joeferner/stm32f1DevBoard/README.md

# STM32F1xxx Dev Board

STM32F1xxx ARM Dev board with Microchip MRF24WB0MA WiFi and SD Card.

## Resources

* [Programming STM32 F2, F4 ARMs under Linux: A Tutorial from Scratch](http://www.triplespark.net/elec/pdev/arm/stm32.html)
* [stm32flash](http://code.google.com/p/stm32flash/)
