joeferner/stm32f1DevBoard/hardware/stm32f1DevBoard.kicad_pcb

## KiCad design hardware/stm32f1DevBoard.kicad_pcb (2013-02-13)

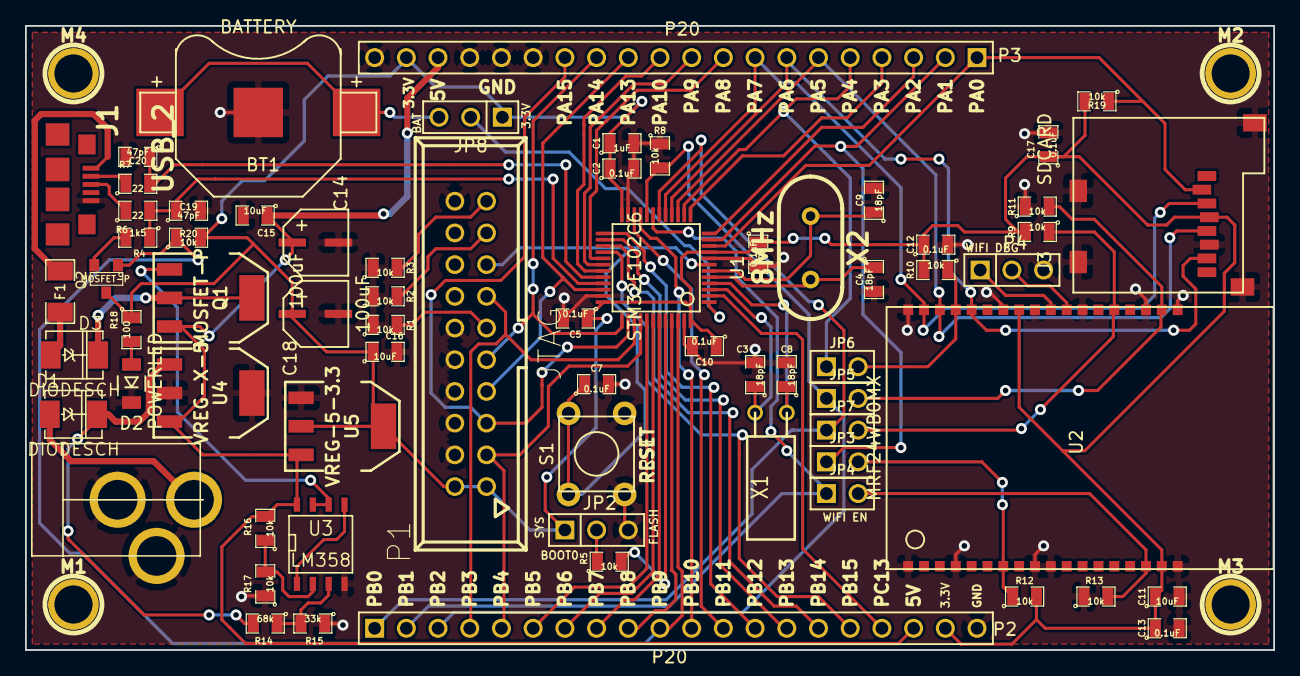
[picture p1: board stm32f1DevBoard.kicad_pcb from above]

Board: 2 copper layers, 100.0 x 50.0 mm, 73 parts (0 on the bottom side), 68 nets.

Parts:
BT1: BATTERY; BATTERY-COIN
C1: 1uF; SM0805
C2, C5, C6, C7, C10, C12, C13, C17: 0.1uF; SM0805
C3, C4, C8, C9: 18pF; SM0805
C11, C15, C16: 10uF; SM0805
C14, C18: 100uF; CAP-CAN-5mm
C19, C20: 47pF; SM0805
D1, D3: DIODESCH; DO-214AC(SMA)
D2: POWERLED; LED-1206
F1: FUSE; SM1206
J1: USB_2; USBMICRO
J2: POWER_JACK; POWER-IN-JACK-PMS
J3: SDCARD
JP2: BOOT0; PIN_ARRAY_3X1
JP3: WIFIRESET; PIN_ARRAY_2X1
JP4: WIFIWP; PIN_ARRAY_2X1
JP5: WIFIHIBERNATE; PIN_ARRAY_2X1
JP6: WIFIINT; PIN_ARRAY_2X1
JP7: WIFICS; PIN_ARRAY_2X1
JP8: BATTERYENABLE; PIN_ARRAY_3X1
M1, M2, M3, M4: Mounting Hole; 1pin
P1: JTAG; VASCH10x2
P2, P3: P20; PIN_ARRAY_20X1
P4: WIFIDEBUG; PIN_ARRAY_3X1
Q1: MOSFET-P; SOT223-321
Q2: MOSFET-P; SOT23
R1, R2, R3, R5, R8, R9, R10, R11, R12, R13, R16, R17, R19, R20: 10k; SM0805
R4: 1k5; SM0805
R6, R7: 22; SM0805
R14: 68k; SM0805
R15: 33k; SM0805
R18: 100; SM0805
S1: RST; SWITCH_TACTILE
U1: STM32F102C6; QFP48
U2: MRF24WB0MX; MRF24WB0Mx
U3: LM358; SO8N
U4: VREG-X-5; SOT223
U5: VREG-5-3.3; SOT223
X1: 32,768Hz; QMONTRE
X2: 8MHz; HC-49V

Connections:
+3.3V: C1.1, C2.1, C5.1, C6.1, C10.1, C11.1, C12.1, C13.1, C16.1, C17.1, C18.1, J3.4, JP2.1, JP8.1, P1.1, P1.2, P2.19, P3.19, Q2.3, R9.2, R10.2, R12.2, R18.1, R19.2, R20.2, U1.9, U1.24, U1.36, U1.48, U2.17, U2.29, U5.2, U5.4
+5V: C14.1, C15.1, P2.18, P3.18, Q1.2, R16.2, U3.8, U4.3, U5.3
/USBD+: J1.3, R6.1
/USBD-: J1.2, R7.1
GND: BT1.2, C1.2, C2.2, C3.2, C4.2, C5.2, C6.2, C7.2, C8.2, C9.2, C10.2, C11.2, C12.2, C13.2, C14.2, C15.2, C16.2, C17.2, C18.2, C19.2, C20.2, D2.2, J1.5, J2.2, J2.3, J3.6, J3.9, JP2.3, P1.4, P1.6, P1.8, P1.10, P1.12, P1.14, P1.16, P1.18, P1.20, P2.20, P3.15, P3.16, P3.17, P3.20, P4.3, R1.1, R2.1, R3.1, R8.1, R11.1, R13.1, R15.1, R17.1, S1.1, S1.2, U1.8, U1.23, U1.35, U1.47, U2.1, U2.4, U2.9, U2.10, U2.18, U2.19, U2.21, U2.25, U2.28, U2.30, U2.36, U3.4, U4.2, U4.4, U5.1
JTCK: P1.9, P3.13, U1.37
JTDI: P1.5, P3.14, U1.38
JTDO: P1.13, P2.4, U1.39
JTMS: P1.7, P3.12, U1.34
MISO: J3.7, P3.7, U1.16, U2.32
MOSI: J3.3, P3.8, U1.17, U2.35
unnamed: P3.9, U1.29
unnamed: P2.16, U1.28
unnamed: P2.15, U1.27
unnamed: P2.14, U1.26
unnamed: P2.9, U1.45
unnamed: P2.13, U1.25
unnamed: P2.8, U1.43
unnamed: P2.17, U1.2
unnamed: P2.12, U1.22
unnamed: P2.11, U1.21
unnamed: P2.7, U1.42
unnamed: P2.6, U1.41
unnamed: C3.1, U1.3, X1.1
unnamed: D3.1, F1.2
unnamed: F1.1, J1.1
unnamed: Q2.2, R4.2
unnamed: P1.11, R1.2
unnamed: P1.19, R3.2
unnamed: P1.17, R2.2
unnamed: C20.1, R7.2, U1.32
unnamed: C8.1, U1.4, X1.2
unnamed: C4.1, U1.5, X2.2
unnamed: R5.2, U1.44
unnamed: JP2.2, R5.1
unnamed: C19.1, R4.1, R6.2, U1.33
unnamed: C9.1, U1.6, X2.1
unnamed: JP4.2, R13.2, U2.16
unnamed: JP5.2, R11.2, U2.20
unnamed: JP3.2, R12.1, U2.7
unnamed: JP7.2, R9.1, U2.23
unnamed: JP6.2, R10.1, U2.33
unnamed: P4.2, U2.26
unnamed: P4.1, U2.27
unnamed: D2.1, R18.2
unnamed: R14.1, R15.2, U3.3
unnamed: R16.1, R17.2, U3.2
unnamed: U3.1, U3.5
unnamed: Q1.1, U3.6, U3.7
unnamed: BT1.1, JP8.3
unnamed: D1.1, J2.1
RX1: P3.11, U1.31
RX2: P3.4, U1.13
SCK: J3.5, P3.6, U1.15, U2.34
SDCS: J3.2, P3.1, R19.1, U1.10
TX1: P3.10, U1.30
TX2: P3.3, U1.12
USBDISC: P2.10, Q2.1, R20.1, U1.46
VBAT: JP8.2, U1.1
VIN: D1.2, R14.2, U4.1
VUSB: D3.2, Q1.3
WIFIHIBERNATE: JP5.1, P2.3, R8.2, U1.20
nJTRST: P1.3, P2.5, U1.40
nRST: C7.1, P1.15, S1.3, S1.4, U1.7
nWIFICS: JP7.1, P2.1, U1.18
nWIFIINT: JP6.1, P3.5, U1.14
nWIFIRESET: JP3.1, P3.2, U1.11
nWIFIWP: JP4.1, P2.2, U1.19
