joeferner/stm32f1DevBoard/firmware/wifiTest/main.cpp

#include <wirish/wirish.h>
#include <mrf24w/mrf24w.h>
#include <string.h>

#define SDCARD_CS           PA0
#define SDCARD_SPI          1

#define WIFI_CS             PB0
#define WIFI_INT            PA4
#define WIFI_CONNECTION_LED PB5
#define WIFI_RESET          PA1
#define WIFI_WP             PB1
#define WIFI_HIBERNATE      PB2
#define WIFI_SPI            SDCARD_SPI

#define ECHO_PORT 8000

uint8_t wifiLocalIp[] = {192, 168, 1, 99};
uint8_t wifiGatewayIp[] = {192, 168, 1, 1};
uint8_t wifiSubnetMask[] = {255, 255, 255, 0};
const char* wifiSSID = "STMWIFI"; //"STMTEST";
const char* wifiSecurityPassphrase = "";
uint8_t wifiSecurityType = WF_SECURITY_OPEN;
uint8_t wifiWirelessMode = WF_INFRASTRUCTURE; //WF_ADHOC;

HardwareSPI spi1(WIFI_SPI);
Mrf24w wifi(spi1, WIFI_CS, WIFI_INT);

void wifiProcessEvent(uint8_t event, uint16_t eventInfo, uint8_t* extraInfo);

void setup() {
  Serial1.begin(19200);
  Serial1.println("begin");

  enableDebugPorts();
  //delay(5000);
  //disableDebugPorts();

  pinMode(SDCARD_CS, OUTPUT);
  digitalWrite(SDCARD_CS, HIGH);
  pinMode(WIFI_CS, OUTPUT);
  digitalWrite(WIFI_CS, HIGH);

  pinMode(WIFI_RESET, OUTPUT);
  pinMode(WIFI_HIBERNATE, OUTPUT);
  digitalWrite(WIFI_HIBERNATE, LOW);
  pinMode(WIFI_WP, OUTPUT);
  digitalWrite(WIFI_WP, LOW);
  pinMode(WIFI_CONNECTION_LED, OUTPUT);
  digitalWrite(WIFI_CONNECTION_LED, LOW);
  spi1.begin(SPI_4_5MHZ, MSBFIRST, 0);

  Serial1.println("wifi setup");
  digitalWrite(WIFI_RESET, LOW);
  delay(100);
  digitalWrite(WIFI_RESET, HIGH);

  wifi.setProcessEventFn(wifiProcessEvent);
  Serial1.println("wifi begin");
  wifi.setLocalIp(wifiLocalIp);
  wifi.setGatewayIp(wifiGatewayIp);
  wifi.setSubnetMask(wifiSubnetMask);
  wifi.setSSID(wifiSSID);
  wifi.setSecurityPassphrase(wifiSecurityPassphrase);
  wifi.setSecurityType(wifiSecurityType);
  wifi.setWirelessMode(wifiWirelessMode);
  wifi.begin();
  Serial1.println("wifi begin complete");

  //wifi.scan(WF_SCAN_ALL);

  wifi.connect();

  //uip_listen(HTONS(ECHO_PORT));
}

int ssss = 0;
struct uip_udp_conn *c;

void loop() {
  wifi.loop();

  while (Serial1.available() > 0) {
    uint8_t b = Serial1.read();
    if (b == 'r') {
      Serial1.println("rebooting 1sec");
      delay(1000);
      nvic_sys_reset();
    }

    if (b == 'c') {
      uip_ipaddr_t addr;

      uip_ipaddr(&addr, 192, 168, 1, 100);
      c = uip_udp_new(&addr, HTONS(1234));
      ssss = 0;
      if (c != NULL) {
        uip_udp_bind(c, HTONS(1234));
        Serial1.println("udp_new");
      } else {
        Serial1.println("udp_new fail");
      }
    }
  }
}

extern "C" void echo_udp_appcall() {
  Serial1.print("echo_udp_appcall: ");
  Serial1.println(ssss);

  if (uip_newdata()) {
    Serial1.print("new data: ");
    Serial1.println(uip_datalen());
    for (int i = 0; i < uip_datalen(); i++) {
      char ch = (char)((uint8_t*)uip_appdata)[i];
      Serial1.print(ch);
    }
    Serial1.println();
  } else if (uip_poll()) {
    if ((ssss % 10) == 0) {
      uip_send("test", 4);
    }
    ssss++;
  }
}

extern "C" void echo_appcall() {
  Serial1.println("echo_appcall");

  if (uip_conn->lport == HTONS(ECHO_PORT)) {
    struct echo_state* s = uip_conn->appstate;

    if (uip_connected()) {
      s->state = ECHO_STATE_WELCOME_SENT;
      uip_send("start echo!", strlen("start echo!"));
    }

    if (uip_acked() && s->state == ECHO_STATE_WELCOME_SENT) {
      s->state = ECHO_STATE_WELCOME_ACKED;
    }

    if (uip_newdata()) {
      uip_send(uip_appdata, uip_datalen());
    }

    if (uip_rexmit()) {
      switch (s->state) {
        case ECHO_STATE_WELCOME_SENT:
          uip_send("start echo!", strlen("start echo!"));
          break;
        case ECHO_STATE_WELCOME_ACKED:
          // don't have the data anymore
          break;
      }
    }
  }
}

extern "C" void uip_log(char *msg) {
  Serial1.println(msg);
}

void wifiProcessEvent(uint8_t event, uint16_t eventInfo, uint8_t* extraInfo) {
  switch (event) {
    case WF_EVENT_CONNECTION_SUCCESSFUL:
    case WF_EVENT_CONNECTION_REESTABLISHED:
      digitalWrite(WIFI_CONNECTION_LED, HIGH);
      break;

    case WF_EVENT_CONNECTION_PERMANENTLY_LOST:
    case WF_EVENT_CONNECTION_TEMPORARILY_LOST:
    case WF_EVENT_CONNECTION_FAILED:
      digitalWrite(WIFI_CONNECTION_LED, LOW);
      break;
  }
}

// Force init to be called *first*, i.e. before static object allocation.
// Otherwise, statically allocated objects that need libmaple may fail.

__attribute__((constructor)) void premain() {
  init();
}

int main(void) {
  setup();

  while (true) {
    loop();
  }

  return 0;
}
