joeferner/stm32f1DevBoard/(commit log)

2012-12-13 more schematic
    [stm32f1DevBoard.sch]
2012-12-16 wifi and sdcard
    [stm32f1DevBoard.sch]
2012-12-16 seperate into sheets
    [stm32f1DevBoard-WiFi.sch, stm32f1DevBoard-power.sch, stm32f1DevBoard-sdcard.sch, stm32f1DevBoard.sch]
2012-12-19 more mods
    [stm32f1DevBoard-WiFi.sch, stm32f1DevBoard-power.sch, stm32f1DevBoard-sdcard.sch, stm32f1DevBoard.kicad_pcb, stm32f1DevBoard.sch]
2012-12-19 pcb initial layout
    [stm32f1DevBoard-WiFi.sch, stm32f1DevBoard-power.sch, stm32f1DevBoard-sdcard.sch, stm32f1DevBoard.sch]
2012-12-20 switched transistor
    [stm32f1DevBoard-WiFi.sch, stm32f1DevBoard-power.sch, stm32f1DevBoard-sdcard.sch, stm32f1DevBoard.kicad_pcb, stm32f1DevBoard.sch]
2012-12-20 changed to p-ch mosfet
    [stm32f1DevBoard-WiFi.sch, stm32f1DevBoard-power.sch, stm32f1DevBoard-sdcard.sch, stm32f1DevBoard.kicad_pcb, stm32f1DevBoard.sch]
2012-12-28 layout complete
    [stm32f1DevBoard.kicad_pcb]
2013-01-02 more board work
    [stm32f1DevBoard.kicad_pcb]
2013-01-02 using kicadcloud files
    [stm32f1DevBoard-WiFi.sch, stm32f1DevBoard-power.sch, stm32f1DevBoard-sdcard.sch, stm32f1DevBoard.sch]
2013-01-10 new v1 - with soldermask
    [stm32f1DevBoard.kicad_pcb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]
2013-01-16 print block0
2013-01-17 switched to sdfat library
2013-01-19 added pull resistor on sdcard cs
    [stm32f1DevBoard-WiFi.sch, stm32f1DevBoard-power.sch, stm32f1DevBoard-sdcard.sch, stm32f1DevBoard.sch]
2013-01-22 updates to schematic
    [stm32f1DevBoard-WiFi.sch, stm32f1DevBoard-power.sch, stm32f1DevBoard-sdcard.sch, stm32f1DevBoard.sch]
2013-01-28 simple test working on board
2013-01-29 fix sdcard
    [stm32f1DevBoard-WiFi.sch, stm32f1DevBoard-power.sch, stm32f1DevBoard-sdcard.sch, stm32f1DevBoard.kicad_pcb, stm32f1DevBoard.sch]
2013-01-29 fixed sdcard
    [stm32f1DevBoard-WiFi.sch, stm32f1DevBoard-power.sch, stm32f1DevBoard-sdcard.sch, stm32f1DevBoard.kicad_pcb, stm32f1DevBoard.sch]
2013-02-01 usb renumber
    [stm32f1DevBoard-WiFi.sch, stm32f1DevBoard-power.sch, stm32f1DevBoard-sdcard.sch, stm32f1DevBoard.kicad_pcb, stm32f1DevBoard.sch]
2013-02-01 pin remap
2013-02-13 update hardware
    [stm32f1DevBoard-WiFi.sch, stm32f1DevBoard-power.sch, stm32f1DevBoard-sdcard.sch, stm32f1DevBoard.kicad_pcb, stm32f1DevBoard.sch]
2013-02-21 working send/recv with errors
    [main.cpp, mrf24w-uip-conf.h]
2013-04-05 new hardware
    [stm32f1DevBoard-WiFi.sch, stm32f1DevBoard-power.sch, stm32f1DevBoard-sdcard.sch, stm32f1DevBoard.sch]
